claudiusmarius/TV-A-BALAYAGE-MECANIQUE-SIGNAUX-VIDEO-DFTA282/Composants.xlsx

Sheet: Feuil1
R1 | 1K
R2 | 47K
R3 | SUPPRIME
R4 | SUPPRIME
R5 | 4,7K
R6 | 10K
R7 | 1M
R8 | 470K
R9 | 47K
R10 | 47K
R11 | 47K
R12 | 47K
R13 | 47K
R14 | 47K
R15 | 470K
R16 | 33
R17 | 15
R18 | 12
R19 | 560
R20 | 10K
R21 | 330
R22 | 2,2K
R23 | 6,8K
R24 | SUPPRIME
R25 | 10K
R26 | SUPPRIME
R27 | 330
R28 | 10K
R29 | 47K
R30 | SUPPRIME
R31 | SUPPRIME
R32 | 1,5K
R33 | 180K
R34 | 100K
R35 | 1K
R36 | 4,7K
R37 | 5,6K
R38 | 180K
R39 | 8,2K
R40 | 1K
R41 | 100K | Monté sur les 2 extrémités de RV7 non installée
R42 | 470K | Face supérieure | volant
R43 | 10K | Face inférieure | volant
R44
R45
R46
R47
R48
R49
RV1
RV2
RV3
RV4 | 10K
RV5 | SUPPRIME
RV6 | 1K |  | Monter un plus grand modèle
RV7 | SUPPRIME
C1 | 100n
C2 | 47µ
C3 | 100n | Face inférieure | ne sert à rien
C4 | 1µ
C5 | STRAPPE |  | ne sert à rien
C6 | 1µ | Face inférieure
C7 | 20p
C8 | 10p
C9 | 100n
C10 | 100n | Face inférieure
C11 | 100n | Face inférieure
C12 | 10µ |  | 25V
C13 | SUPPRIME
C14 | 3,3µ
C15 | 1µ
C16
TP1 | OK
TP2 | OK
TP3 | OK
TP4 | OK
TP5 | SUPPRIME
TP6 | OK
TP7 | SUPPRIME
TP8 | OK
TP9 | OK
TP10 | OK
TP11 | OK
TP12 | OK
TP13 | OK
TP14 | OK
TP15 | OK
TP16 | OK
TP17 | OK
TP18 | SUPPRIME
TP19 | SUPPRIME
D1
D2 | 1N4148
D3 | 1N5819 | Schottky
D4 | 1N4148
D5 | LED Jaune | 5mm
Q1
Q2
Q3
Q4
Q5 | 2N2222 | Volant face supérieure
J12 | JST 3 Droit
J13 | JST 3 Droit
J14 | JST 3 Droit

Sheet: U2
 | ESSAIS A BLANC U2
 | Absence de LM324 sur U2
 | Brancher le 15V sur J7
1> | Shunter J6
 | Brancher le double génateur de courant (breadboard)
 |  |  | Théorique | Mesuré
 | Mesure la tension sur le point commen de R7 et R8
 | (Attention Multicomp MP720783 impédance 10M |  | 4.796 | 4.717
 | Régler
 | I Constant 1 pour avoir | VB | 2.12 | 2.152
 |  | TP8 | 2 | 2.09
 | I Constant 2 pour avoir | TP9 | 2.33 | 2.331
2> | Poser un LM324 SUR U2
 | Injecter une mire sur J6
 | Vérifier | TP1
 |  | TP2
 |  | TP3

Sheet: U3
LM324 non posé
 | V+
 | Théorique | Mesuré
J10 stappé
 | 5.35 | 5.322
 | V+
J8 strappé | 0.65 | 0.65
 |  |  | 15
 |  |  | 180
 |  |  | 8.2 | 0.6535600425
