claudiusmarius/TV-A-BALAYAGE-MECANIQUE-SIGNAUX-VIDEO-DFTA282/Schematic_DFTA282_2026-10-10.pdf

# Q510KR43

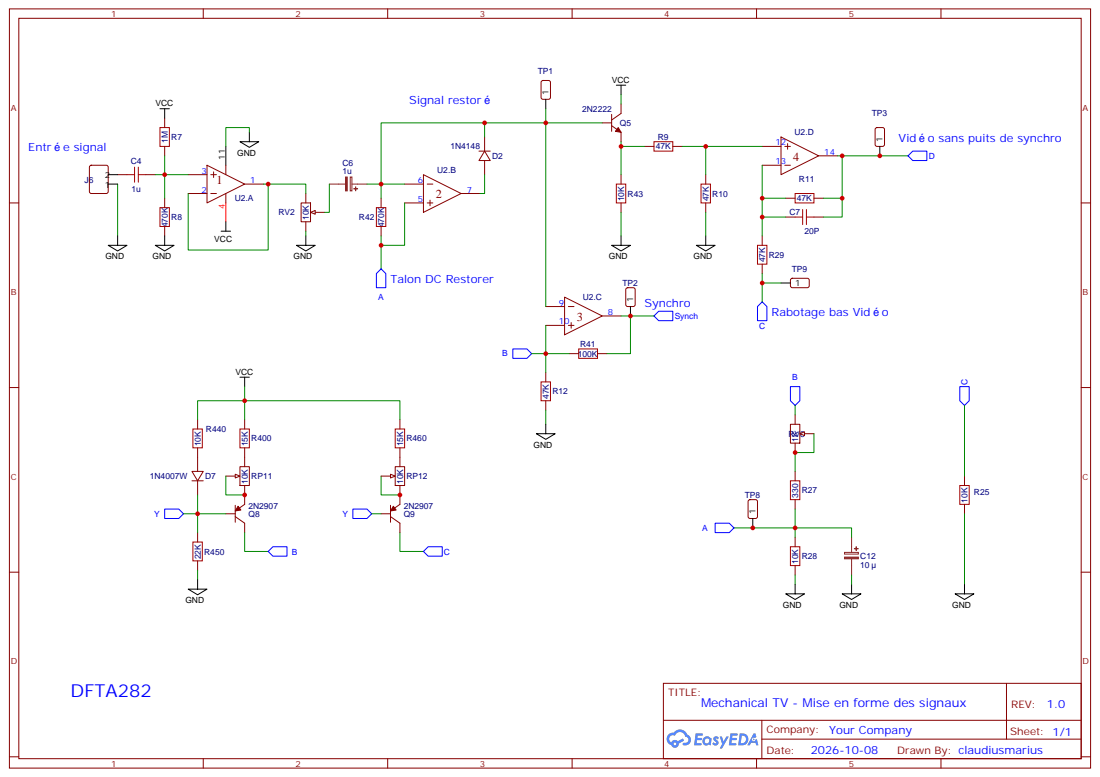
[picture p1: page 1]
