claudiusmarius/TV-A-BALAYAGE-MECANIQUE-SIGNAUX-VIDEO-DFTA282/Draft6.asc

C2: cap; 20p
C4: cap; 100n
C5: cap; 22µ
C6: cap; 22µ
C12: cap; 10µ
C14: cap; 22µ
C15: cap; 22µ
D1: diode; 1N4148
D2: diode; 1N4148
Q1: npn; 2N2222
Q8: pnp; 2N2907
Q9: pnp; 2N2907
R1: res; 47k
R2: res; 47K
R3: res; 100k
R4: res; 10K
R7: res; 1000k
R8: res; 470k
R9: res; 47k
R10: res; 47k
R11: res; 2k
R12: res; 1.5k
R13: res; 47k
R22: res; 1000k
R25: res; 10K
R27: res; 330
R28: res; 10K
R33: res; 180k
R34: res; 100k
R35: res; 1k
R36: res; 4.7K
R37: res; 5.6k
R38: res; 180k
R39: res; 20k
R40: res; 1k
R400: res; 15k
R440: res; 10k
R450: res; 22k
R460: res; 15k
RP11: res; 500
RP12: res; 4K
RPlus1: res; 470k
RTEST1: res; 1
RV1Bas: res; 9k
RV1Haut: res; 1k
RV6: res; 500
U1: LT1006
U2: LT1006
U2A: LT1006
U2B: LT1006
U3C: LT1006
U3D: LT1006
U5: LT1006
V1: voltage; PWL REPEAT FOR 2000 (0 1 0.095m 1 0.1m 0.67 0.395m 0.67 0.4m 0.55 0.695m 0.55 0.7m 0.25 0.995m 0.25 1m 0.16 1.295m 0.16 1.3m 0 1.595m 0 1.6m 0.34 1.895m 0.34 1.9m 0.55 2.195m 0.55 2.2m 0.16 2.395m 0.16 2.4m 1) ENDREPEAT
V2: voltage; 15
Named nets: 0, +VCC, VS1, VE, VS2, VC, TP1, V0, out, TP7, TP8, outout, synch, TP9, VBQ, Vponpom
.tran 0 3 0 .00001
G = 5.6 INVERSE
DC RESTORER
Potar 1K
Potar 10K
Potar 10K
G = 5.7 DIRECT
SELON LE BESOIN
ON PLACERA
UN DE CES 2 AMPLIS
AVANT L'ETAGE D'ENTREE
TRIGGER DE SCHMITT
SOUSTRACTEUR
SUPER PONT
Surtout pas de condensateur ici
